k-omura/Quadcopter/README.md

# Quadcopter with PIC18F1230 and ESP8266.
Make a quadcopter from 0.  

PIC18F1230 as the BLDC driver and ESP 8266 as the central control unit.  
Do not use commercially available BLDC ESC.  

----------------------------

# BLDC driver
https://github.com/k-omura/SensorlessBLDC
