k-omura/Quadcopter/cirquit/cirquit.brd

## EAGLE design cirquit/cirquit.brd (2018-01-01)

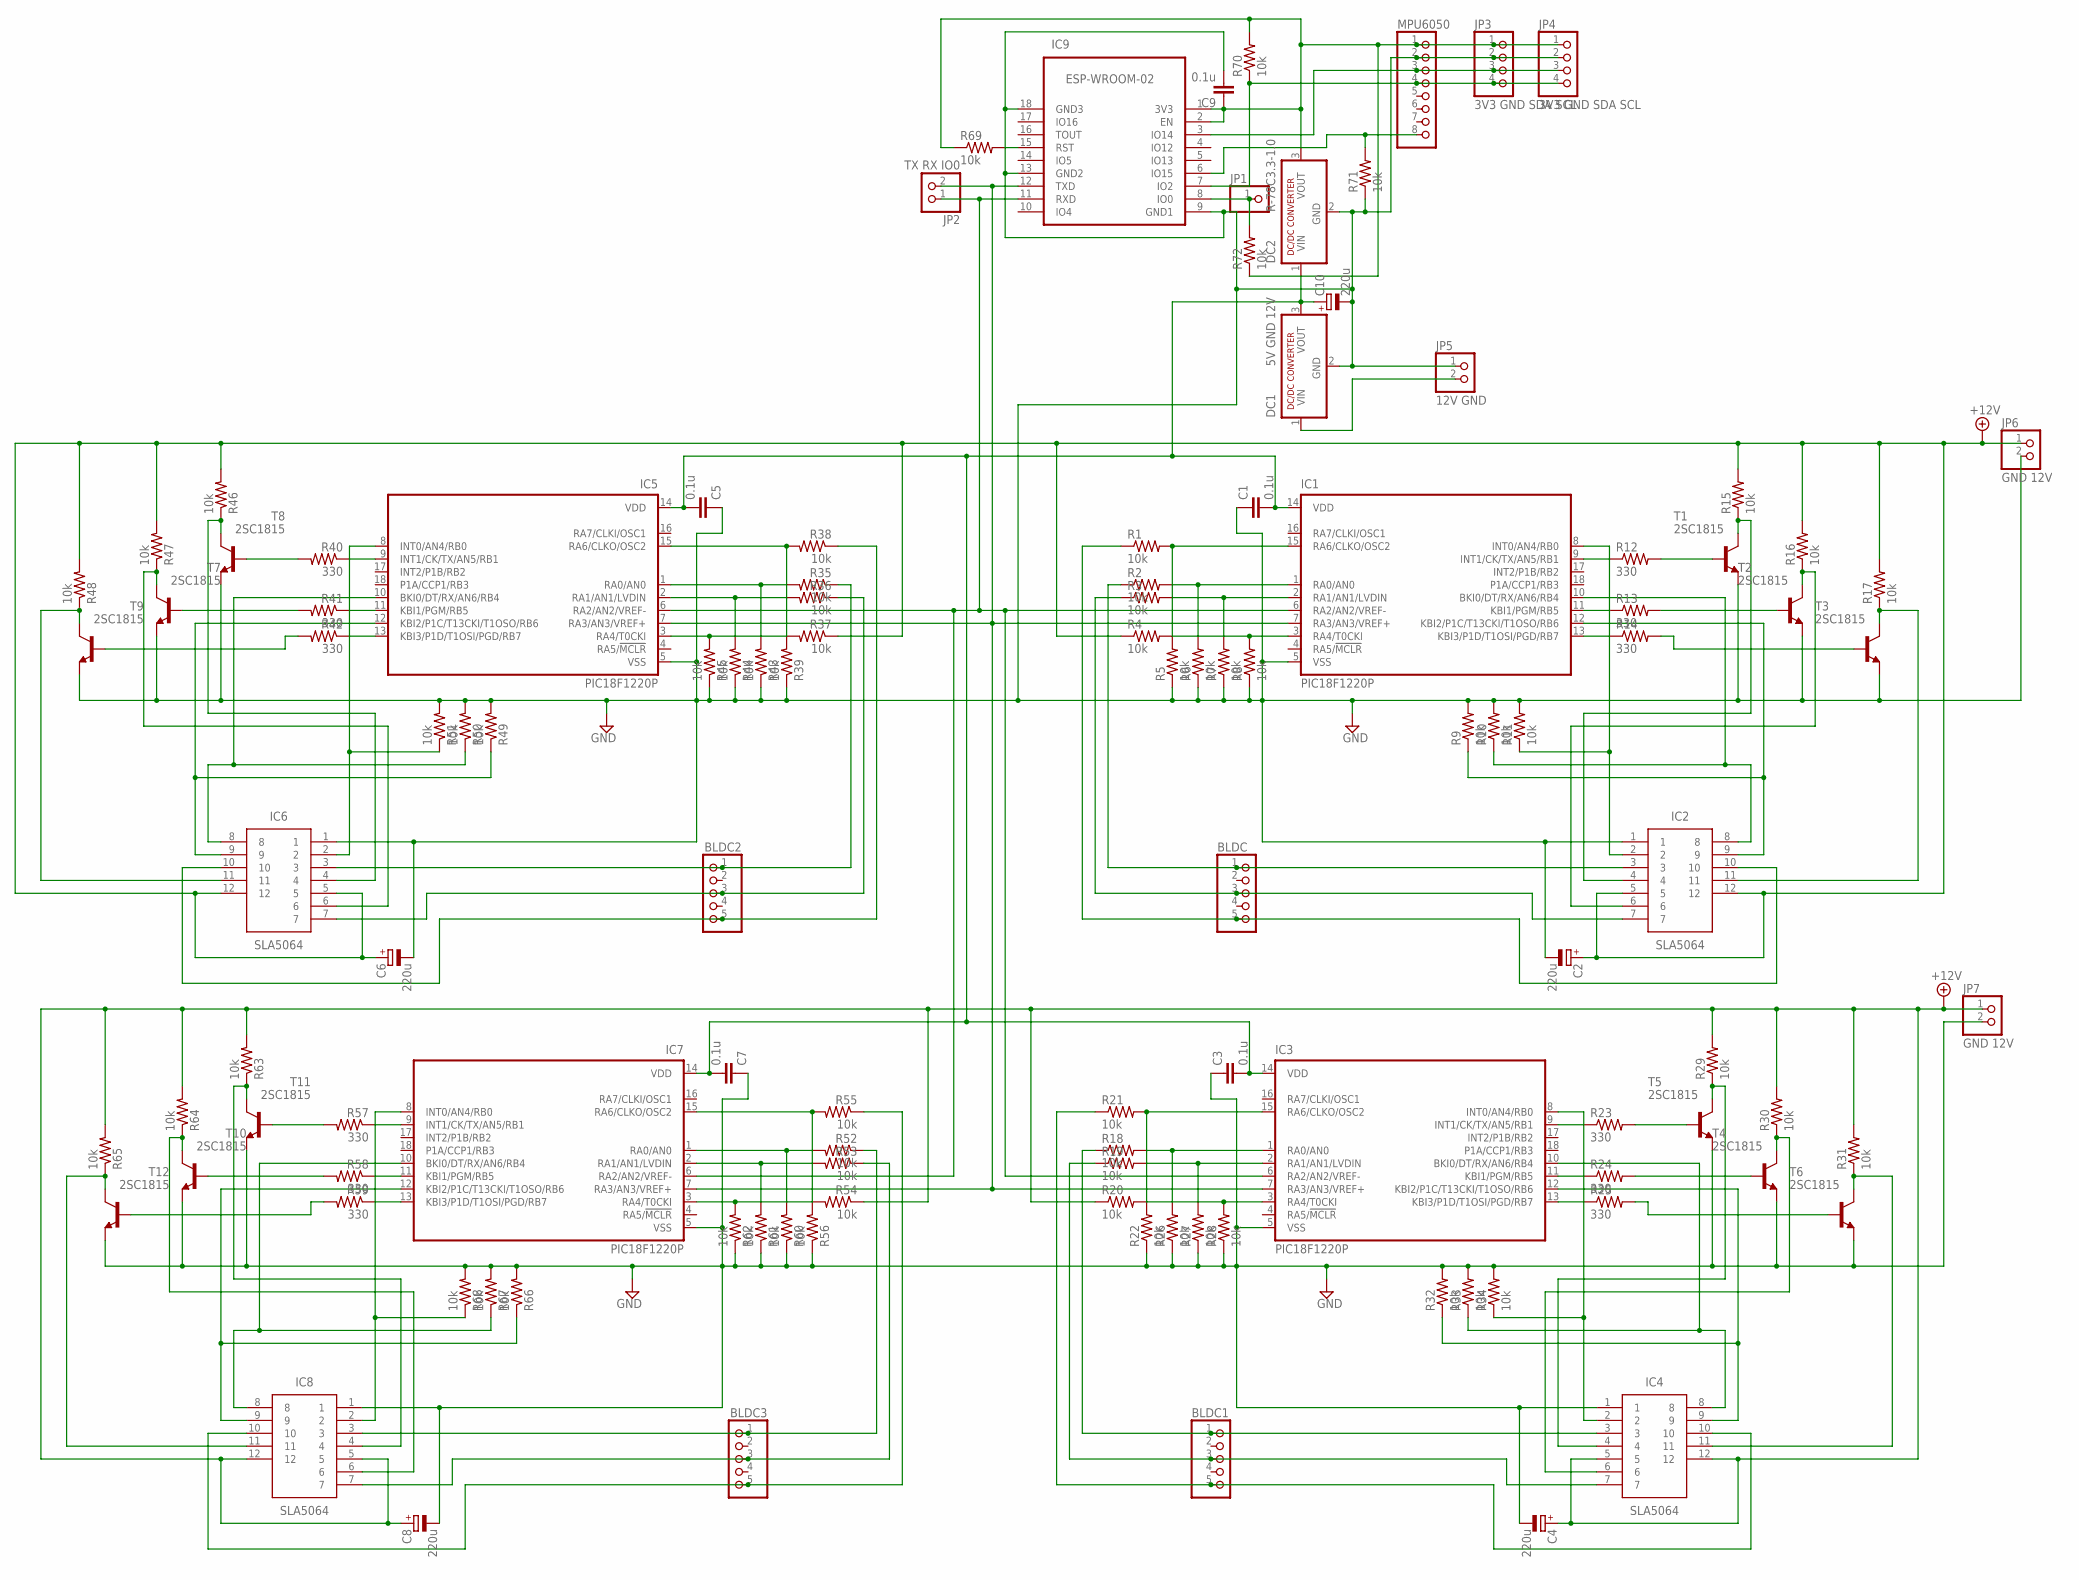
[picture p1: schematic cirquit.sch]

Parts:
BLDC, BLDC1, BLDC2, BLDC3: PINHD-1X5; 1X05
C1, C3, C5, C7, C9: 0.1u; C2.5-2
C2, C4, C6, C8, C10: 220u; E2,5-6E
DC1: 5V GND 12V; SIP3
DC2: R-78C3.3-1.0; SIP3
IC1, IC3, IC5, IC7: PIC18F1220P; DIL18
IC2, IC4, IC6, IC8: SLA5064; TO254P500X3150X1890-12P
IC9: ESP-WROOM-02; FRONT-FACE
JP1: PINHD-1X1; 1X01
JP2: TX RX IO0; 1X02
JP3, JP4: 3V3 GND SDA SCL; 1X04
JP5: 12V GND; 1X02
JP6, JP7: GND 12V; 1X02
MPU6050: PINHD-1X8; 1X08
R1, R2, R3, R4, R5, R6, R7, R8, R9, R10, R11, R15, R16, R17, R18, R19, R20, R21, R22, R26, R27, R28, R29, R30, R31, R32, R33, R34, R35, R36, R37, R38, R39, R43, R44, R45, R46, R47, R48, R49, R50, R51, R52, R53, R54, R55, R56, R60, R61, R62, R63, R64, R65, R66, R67, R68, R69, R70, R71, R72: 10k; 0204/7
R12, R13, R14, R23, R24, R25, R40, R41, R42, R57, R58, R59: 330; 0204/7
T1, T2, T3, T4, T5, T6, T7, T8, T9, T10, T11, T12: 2SC1815; TO92-ECB

Connections:
+12V: C2.+, C4.+, C6.+, C8.+, IC2.5, IC2.12, IC4.5, IC4.12, IC6.5, IC6.12, IC8.5, IC8.12, JP6.1, JP7.1, R4.1, R15.2, R16.2, R17.2, R20.1, R29.2, R30.2, R31.2, R37.1, R46.2, R47.2, R48.2, R54.1, R63.2, R64.2, R65.2
GND: C1.1, C2.-, C3.1, C4.-, C5.1, C6.-, C7.1, C8.-, C9.2, C10.-, DC1.2 (GND), DC2.2 (GND), IC1.5 (VSS), IC2.1, IC3.5 (VSS), IC4.1, IC5.5 (VSS), IC6.1, IC7.5 (VSS), IC8.1, IC9.9 (GND1), IC9.13 (GND2), IC9.18 (GND3), JP3.2, JP4.2, JP5.1, JP6.2, JP7.2, MPU6050.2, R5.1, R6.1, R7.1, R8.1, R9.2, R10.2, R11.2, R22.1, R26.1, R27.1, R28.1, R32.2, R33.2, R34.2, R39.1, R43.1, R44.1, R45.1, R49.2, R50.2, R51.2, R56.1, R60.1, R61.1, R62.1, R66.2, R67.2, R68.2, R71.1, T1.E, T2.E, T3.E, T4.E, T5.E, T6.E, T7.E, T8.E, T9.E, T10.E, T11.E, T12.E
unnamed: IC1.15 (RA6/CLKO/OSC2), R1.2, R5.2
unnamed: IC1.1 (RA0/AN0), R2.2, R6.2
unnamed: IC1.2 (RA1/AN1/LVDIN), R3.2, R7.2
unnamed: IC1.3 (RA4/T0CKI), R4.2, R8.2
unnamed: IC3.15 (RA6/CLKO/OSC2), R21.2, R22.2
unnamed: BLDC.1, IC2.3, R2.1
unnamed: BLDC.3, IC2.7, R3.1
unnamed: IC3.1 (RA0/AN0), R18.2, R26.2
unnamed: IC1.9 (INT1/CK/TX/AN5/RB1), R12.1
unnamed: IC1.11 (KBI1/PGM/RB5), R13.1
unnamed: IC1.13 (KBI3/P1D/T1OSI/PGD/RB7), R14.1
unnamed: R12.2, T1.B
unnamed: R13.2, T2.B
unnamed: R14.2, T3.B
unnamed: IC2.4, R15.1, T1.C
unnamed: IC2.6, R16.1, T2.C
unnamed: IC2.11, R17.1, T3.C
unnamed: IC3.2 (RA1/AN1/LVDIN), R19.2, R27.2
unnamed: IC3.3 (RA4/T0CKI), R20.2, R28.2
unnamed: BLDC1.1, IC4.3, R18.1
unnamed: BLDC1.3, IC4.7, R19.1
unnamed: IC1.8 (INT0/AN4/RB0), IC2.2, R11.1
unnamed: IC1.10 (BKI0/DT/RX/AN6/RB4), IC2.8, R10.1
unnamed: IC1.12 (KBI2/P1C/T13CKI/T1OSO/RB6), IC2.9, R9.1
unnamed: IC1.6 (RA2/AN2/VREF-), IC3.6 (RA2/AN2/VREF-), IC5.6 (RA2/AN2/VREF-), IC7.6 (RA2/AN2/VREF-), IC9.11 (RXD), JP2.1
unnamed: C1.2, C3.2, C5.2, C7.2, C10.+, DC1.3 (VOUT), DC2.1 (VIN), IC1.14 (VDD), IC3.14 (VDD), IC5.14 (VDD), IC7.14 (VDD)
unnamed: IC3.9 (INT1/CK/TX/AN5/RB1), R23.1
unnamed: IC3.11 (KBI1/PGM/RB5), R24.1
unnamed: BLDC.5, IC2.10, R1.1
unnamed: IC3.13 (KBI3/P1D/T1OSI/PGD/RB7), R25.1
unnamed: R23.2, T5.B
unnamed: R24.2, T4.B
unnamed: R25.2, T6.B
unnamed: IC4.4, R29.1, T5.C
unnamed: IC4.6, R30.1, T4.C
unnamed: IC4.11, R31.1, T6.C
unnamed: IC3.8 (INT0/AN4/RB0), IC4.2, R34.1
unnamed: IC3.10 (BKI0/DT/RX/AN6/RB4), IC4.8, R33.1
unnamed: IC3.12 (KBI2/P1C/T13CKI/T1OSO/RB6), IC4.9, R32.1
unnamed: IC5.15 (RA6/CLKO/OSC2), R38.2, R39.2
unnamed: C9.1, DC2.3 (VOUT), IC9.1 (3V3), IC9.2 (EN), JP3.1, JP4.1, MPU6050.1, R69.1, R70.2, R72.1
unnamed: BLDC1.5, IC4.10, R21.1
unnamed: IC5.1 (RA0/AN0), R35.2, R43.2
unnamed: IC5.2 (RA1/AN1/LVDIN), R36.2, R44.2
unnamed: IC5.3 (RA4/T0CKI), R37.2, R45.2
unnamed: BLDC2.1, IC6.3, R35.1
unnamed: BLDC2.3, IC6.7, R36.1
unnamed: IC5.9 (INT1/CK/TX/AN5/RB1), R40.1
unnamed: IC5.11 (KBI1/PGM/RB5), R41.1
unnamed: IC5.13 (KBI3/P1D/T1OSI/PGD/RB7), R42.1
unnamed: R40.2, T8.B
unnamed: R41.2, T7.B
unnamed: R42.2, T9.B
unnamed: IC6.4, R46.1, T8.C
unnamed: IC6.6, R47.1, T7.C
unnamed: IC6.11, R48.1, T9.C
unnamed: IC5.8 (INT0/AN4/RB0), IC6.2, R51.1
unnamed: IC5.10 (BKI0/DT/RX/AN6/RB4), IC6.8, R50.1
unnamed: IC5.12 (KBI2/P1C/T13CKI/T1OSO/RB6), IC6.9, R49.1
unnamed: IC1.7 (RA3/AN3/VREF+), IC3.7 (RA3/AN3/VREF+), IC5.7 (RA3/AN3/VREF+), IC7.7 (RA3/AN3/VREF+), IC9.12 (TXD), JP2.2
unnamed: DC1.1 (VIN), JP5.2
unnamed: BLDC2.5, IC6.10, R38.1
unnamed: IC7.15 (RA6/CLKO/OSC2), R55.2, R56.2
unnamed: IC7.1 (RA0/AN0), R52.2, R60.2
unnamed: IC7.2 (RA1/AN1/LVDIN), R53.2, R61.2
unnamed: IC7.3 (RA4/T0CKI), R54.2, R62.2
unnamed: BLDC3.1, IC8.3, R52.1
unnamed: BLDC3.3, IC8.7, R53.1
unnamed: IC7.9 (INT1/CK/TX/AN5/RB1), R57.1
unnamed: IC7.11 (KBI1/PGM/RB5), R58.1
unnamed: IC7.13 (KBI3/P1D/T1OSI/PGD/RB7), R59.1
unnamed: R57.2, T11.B
unnamed: R58.2, T10.B
unnamed: R59.2, T12.B
unnamed: IC8.4, R63.1, T11.C
unnamed: IC8.6, R64.1, T10.C
unnamed: IC8.11, R65.1, T12.C
unnamed: IC7.8 (INT0/AN4/RB0), IC8.2, R68.1
unnamed: IC7.10 (BKI0/DT/RX/AN6/RB4), IC8.8, R67.1
unnamed: IC7.12 (KBI2/P1C/T13CKI/T1OSO/RB6), IC8.9, R66.1
unnamed: IC9.3 (IO14), JP3.3, JP4.3, MPU6050.3
unnamed: BLDC3.5, IC8.10, R55.1
unnamed: IC9.7 (IO2), JP3.4, JP4.4, MPU6050.4, R70.1
unnamed: IC9.6 (IO15), MPU6050.8, R71.2
unnamed: IC9.15 (RST), R69.2
unnamed: IC9.8 (IO0), JP1.1, R72.2

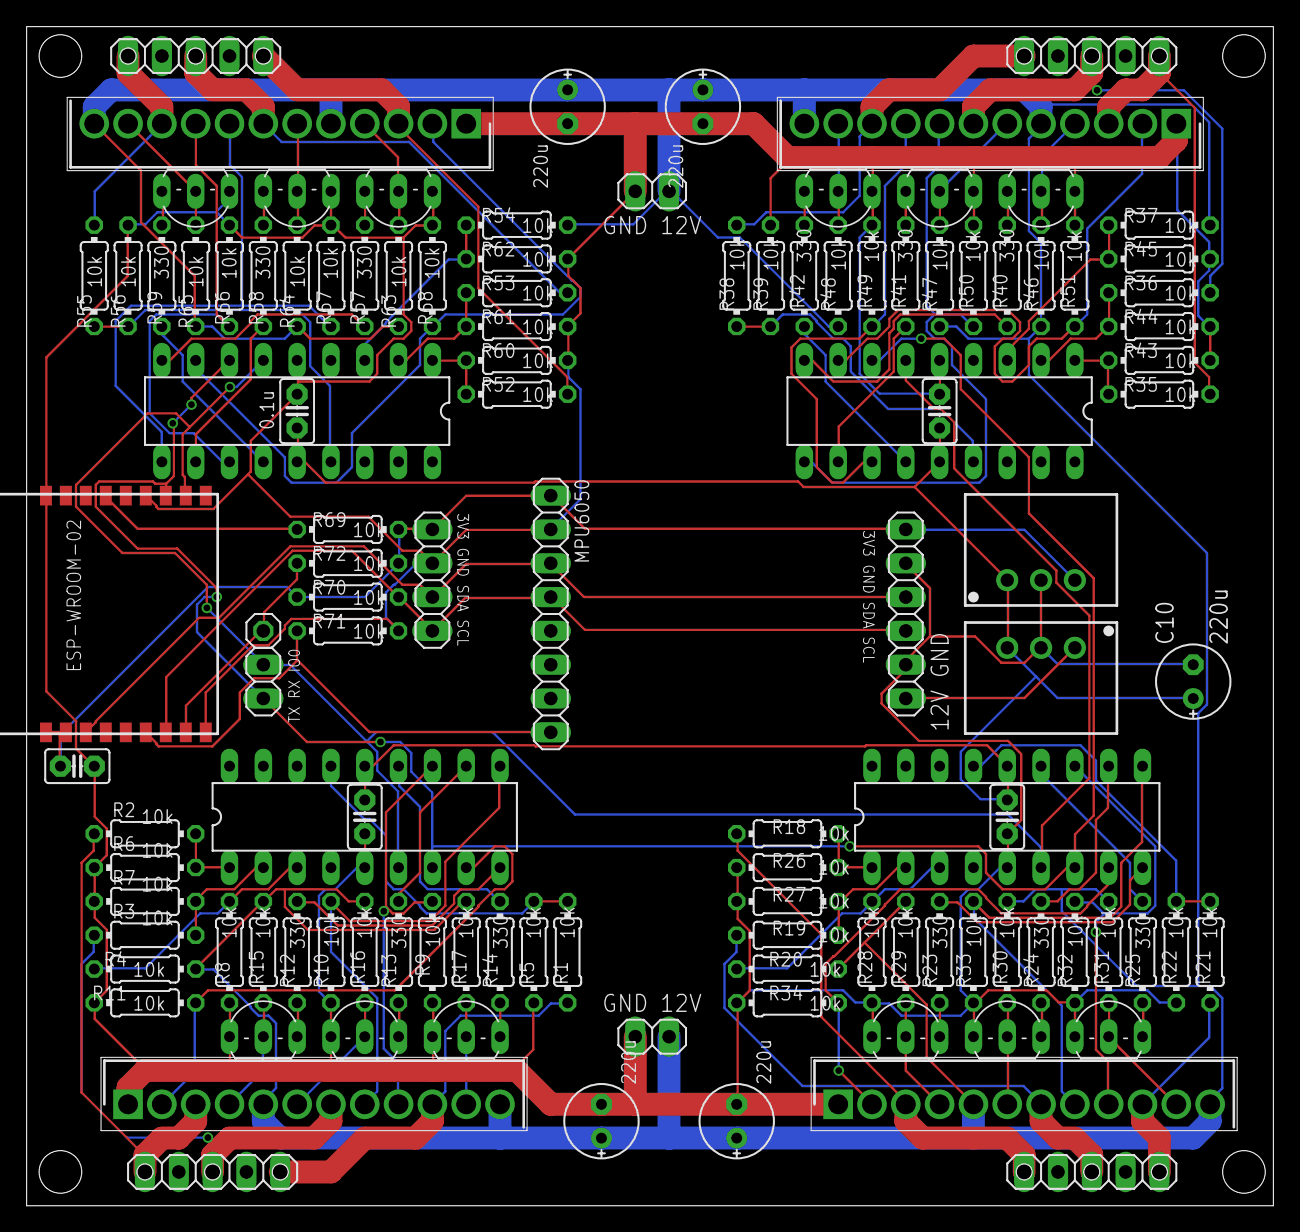
[picture p2: board cirquit.brd from above]

Board: 2 copper layers, 93.7 x 88.6 mm, 117 parts (0 on the bottom side), 88 nets.
