k-omura/Quadcopter/main(BLDC driver).c

/*
 * Created on August 28, 2017
 * August 30, 2017: ADC/PWM test
 * September 10, 2017: Open-loop
 * September 12, 2017: Closed-loop
 * September 13, 2017: Seamless transition Open to Closed, lock detection(CL)
 * January 1, 2018: lock detection(OL)
 * 
 * MPLAB X(XC8)
 * 
 * PWM0: U Nch (Low side)
 * PWM1: U Pch (High side)
 * PWM2: V Nch (Low side)
 * PWM3: V Pch (High side)
 * PWM4: W Nch (Low side)
 * PWM5: W Pch (High side)
 * 
 * ADC0: U
 * ADC1: V
 * ADC2: Supply voltage for motor drive (Vref source -> Vref+ pin)
 * ADC3: W
 * 
 * Speed input EUSART(for quadcopter control)
 * Use RX pin only.
 * Lower 2 bits: address
 * Upper 6 bits: speed data(Absolute)
 */

// PIC18F1230 Configuration Bit Settings

// 'C' source line config statements

// CONFIG1H
#pragma config OSC = INTIO2     // Oscillator (Internal oscillator, port function on RA6 and RA7)
#pragma config FCMEN = OFF      // Fail-Safe Clock Monitor Enable bit (Fail-Safe Clock Monitor disabled)
#pragma config IESO = OFF       // Internal/External Oscillator Switchover bit (Oscillator Switchover mode disabled)

// CONFIG2L
#pragma config PWRT = OFF       // Power-up Timer Enable bit (PWRT disabled)
#pragma config BOR = OFF        // Brown-out Reset Enable bits (Brown-out Reset disabled in hardware and software)
#pragma config BORV = 3         // Brown-out Reset Voltage bits (Minimum setting)

// CONFIG2H
#pragma config WDT = OFF        // Watchdog Timer Enable bit (WDT disabled (control is placed on the SWDTEN bit))
#pragma config WDTPS = 32768    // Watchdog Timer Postscale Select bits (1:32768)

// CONFIG3L
#pragma config PWMPIN = OFF     // PWM Output Pins Reset State Control bit (PWM outputs disabled upon Reset)
#pragma config LPOL = HIGH      // Low-Side Transistors Polarity bit (Even PWM Output Polarity Control bit) (PWM0, PWM2 and PWM4 are active-high (default))
#pragma config HPOL = HIGH      // High Side Transistors Polarity bit (Odd PWM Output Polarity Control bit) (PWM1, PWM3 and PWM5 are active-high (default))

// CONFIG3H
#pragma config FLTAMX = RA5     // FLTA Mux bit (FLTA input is muxed onto RA5)
#pragma config T1OSCMX = LOW    // T1OSO/T1CKI MUX bit (T1OSO/T1CKI pin resides on RB2)
#pragma config MCLRE = OFF      // Master Clear Enable bit (RA5 input pin enabled, MCLR pin disabled)

// CONFIG4L
#pragma config STVREN = OFF     // Stack Overflow/Underflow Reset Enable bit (Reset on stack overflow/underflow disabled)
#pragma config BBSIZ = BB256    // Boot Block Size Select bits (256 Words (512 Bytes) Boot Block size)
#pragma config XINST = OFF      // Extended Instruction Set Enable bit (Instruction set extension and Indexed Addressing mode disabled)

// CONFIG5L
#pragma config CP0 = OFF        // Code Protection bit Block 0 (000400-0007FF) (Block 0 is not code-protected)
#pragma config CP1 = OFF        // Code Protection bit Block 1 (000800-000FFF) (Block 1 is not code-protected)

// CONFIG5H
#pragma config CPB = OFF        // Code Protection bit (Boot Block Memory Area) (Boot Block is not code-protected)
#pragma config CPD = OFF        // Code Protection bit (Data EEPROM) (Data EEPROM is not code-protected)

// CONFIG6L
#pragma config WRT0 = OFF       // Write Protection bit Block 0 (000400-0007FF) (Block 0 is not write-protected)
#pragma config WRT1 = OFF       // Write Protection bit Block 1 (000800-000FFF) (Block 1 is not write-protected)

// CONFIG6H
#pragma config WRTC = OFF       // Write Protection bit (Configuration Registers) (Configuration registers are not write-protected)
#pragma config WRTB = OFF       // Write Protection bit (Boot Block Memory Area) (Boot Block is not write-protected)
#pragma config WRTD = OFF       // Write Protection bit (Data EEPROM) (Data EEPROM is not write-protected)

// CONFIG7L
#pragma config EBTR0 = OFF      // Table Read Protection bit Block 0 (000400-0007FF) (Block 0 is not protected from table reads executed in other blocks)
#pragma config EBTR1 = OFF      // Table Read Protection bit Block 1 (000800-000FFF) (Block 1 is not protected from table reads executed in other blocks)

// CONFIG7H
#pragma config EBTRB = OFF      // Table Read Protection bit (Boot Block Memory Area) (Boot Block is not protected from table reads executed in other blocks)

// #pragma config statements should precede project file includes.
// Use project enums instead of #define for ON and OFF.

#include <xc.h>

#define _XTAL_FREQ 32000000
#define motorADCThreshold 0x80 // (Vmotor / 2) Adjust the value by looking at the oscilloscope, if necessary.
#define CLLockDetectionThreshold 1000
#define OLLockDetectionThreshold 800

//configurations (Set for A2212 13T 1000KV)
#define eusartAddress 0b11 //EUSART Lower 2 bits, use as address.
#define configDirection 0 //rotate direction 0:CW /1:CCW /others:stop
#define configOLDuty 0b00010001 //Open-loop duty
#define configOLInitialSpeed 200 //Open-loop initial speed
#define configOpenToLoopSpeed 50 //Open to close speed (Open-loop max speed)
#define configOLaccelerate 2 //Open-loop "OLInitialSpeed" to "openToLoopSpeed" acceleration
#define configCLaccelerate 30 //Closed-loop acceleration
//configurations end

//functions
int math_abs(int);
void BLDCPosition(int);
void setDuty(unsigned int);
char chageDutySmoothly(unsigned int, unsigned int);
void nextState(unsigned char);

//var
unsigned char motorPosition;
unsigned char direction; //rotation direction. 0, 1, others
unsigned char CLEnable = 0;
unsigned char reachO2CSpeed = 0;
unsigned char LockDetected = 0;

unsigned char eusartReceiveDataGet = 0; //flag read value

typedef union {
    unsigned char raw;

    struct split {
        unsigned int address : 2;
        unsigned int data : 6;
    } split;
} eusartFormat;
eusartFormat eusartReceive;

//const
const unsigned char ADCPortCHS[3] = {0b00, 0b01, 0b11};
const unsigned char feedBackConstant[2][6] = {
    {
        0b00000110,
        0b00000100,
        0b00000101,
        0b00000001,
        0b00000011,
        0b00000010
    },
    {
        0b00000010,
        0b00000110,
        0b00000100,
        0b00000101,
        0b00000001,
        0b00000011
    }
};

void interrupt isr() {
    static unsigned char ADCPortNum = 0; //counter for ADCPortCHS
    static unsigned char ADCValue[3] = {0};
    static unsigned int CLLockDetectionCount = 0, OLLockDetectionCount = 0;
    static int eusartReceiveData = 0, prevEusartReceiveData = 0;

    unsigned char BEMFValue;

    if (PIR1bits.ADIF) {
        ADCValue[ADCPortNum] = ADRESH;

        ADCPortNum = (ADCPortNum >= 2) ? 0 : ADCPortNum + 1;

        if (ADCPortNum == 0) { //AD Convert all of UVW
            //BEMF
            BEMFValue = 0b00000000;
            BEMFValue += (ADCValue[0] > motorADCThreshold) ? 0b00000001 : 0;
            BEMFValue += (ADCValue[1] > motorADCThreshold) ? 0b00000010 : 0;
            BEMFValue += (ADCValue[2] > motorADCThreshold) ? 0b00000100 : 0;

            if ((feedBackConstant[direction][motorPosition] == BEMFValue) && reachO2CSpeed) {
                //change motor position
                nextState(direction);
                CLLockDetectionCount = 0;
                OLLockDetectionCount = 0;
                CLEnable = 1;
            } else if (!CLEnable && reachO2CSpeed && (OLLockDetectionThreshold < OLLockDetectionCount++)) {
                //lock detected(OL)
                reachO2CSpeed = 0;
                BLDCPosition(100);
                setDuty(0x00);
                CLEnable = 0;
                CLLockDetectionCount = 0;
                OLLockDetectionCount = 0;
                LockDetected = 1;
            } else if (CLEnable && (CLLockDetectionThreshold < CLLockDetectionCount++)) {
                //lock detected(CL)
                reachO2CSpeed = 0;
                BLDCPosition(100);
                setDuty(0x00);
                CLEnable = 0;
                CLLockDetectionCount = 0;
                OLLockDetectionCount = 0;
                LockDetected = 1;
            }
        }

        ADCON0bits.CHS = ADCPortCHS[ADCPortNum];
        PIR1bits.ADIF = 0;
    }
    if (PIR1bits.RCIF) {
        if (RCSTAbits.OERR || RCSTAbits.FERR) {//error
            RCSTAbits.CREN = 0;
            eusartReceiveData = RCREG;
            RCSTAbits.CREN = 1;
        } else {
            eusartReceiveData = RCREG;
            //Correspond to irregular input due to noise
            if (eusartReceiveData == prevEusartReceiveData) {
                eusartReceive.raw = eusartReceiveData;
            }
            prevEusartReceiveData = eusartReceiveData;
            eusartReceiveDataGet = 0;
        }
        PIR1bits.RCIF = 0;
    }
    /*
    if (INTCONbits.TMR0IF) {
        INTCONbits.TMR0IF = 0;
    }
     */

    return;
}

void main(void) {
    OSCCON = 0b01110000; //INTOSC 8MHz
    OSCTUNE = 0b01000000; //PLL on

    TRISA = 0b01011011; //AN0-3, RX input
    TRISB = 0b00000000;
    PORTA = 0b00000000;
    PORTB = 0b00000000;

    //interrupt
    INTCON = 0b11000000; //
    INTCON2 = 0b00000000;
    INTCON3 = 0b00000000;

    //configure timer 0
    T0CON = 0b01000000;

    //configure ADC
    ADCON0 = 0b10000000; //Special Event Trigger Enable
    ADCON1 = 0b00010000; //Vref source -> Vref+ pin
    ADCON2 = 0b00001000; //left justified

    //configure PWM
    PTCON0 = 0b00000010; //Postscale 1:1, Fosc/4 Prescale 1:1
    PTCON1 = 0b10000000; //Time base in ON, Time base counts up
    PWMCON0 = 0b01000111; //All PWM I/O pins enabled for PWM output, Independent mode for all pins
    PWMCON1 = 0b00000001; //Postscale 1:1, special event on count downwards, updates from Duty Cycle and Period Buffers enabled
    OVDCOND = 0b00000000;
    OVDCONS = 0b00000000;
    //Period control for all PWM output
    PTPERH = 0x00;
    PTPERL = 0x3f; //8bit PWM
    DTCON = 0b00000110;
    SEVTCMPH = 0;
    SEVTCMPL = 1;
    //FLTCONFIG = 0b00000010;

    PDC0H = 0; //Duty Cycle control for PWM0/1
    PDC0L = 0; //Duty Cycle control for PWM0/1

    PDC1H = 0; //Duty Cycle control for PWM2/3
    PDC1L = 0; //Duty Cycle control for PWM2/3

    PDC2H = 0; //Duty Cycle control for PWM4/5
    PDC2L = 0; //Duty Cycle control for PWM4/5
    chageDutySmoothly(0, 0);

    //configure EUSART receive
    TXSTA = 0b00000100; //BRGH = 1 high speed
    RCSTA = 0b10010000;
    BAUDCON = 0b00001000; //16-bit Baud Rate Generator
    SPBRGH = 0;
    SPBRG = 68; //Baud Rate 9600 (Formula: 9603.842)
    /*
     * SPBRG = 138; //Baud Rate 57600 (Formula: 57553.957)
     * SPBRG = 68; //Baud Rate 115200 (Formula: 115942.029)
     */

    //start timer 0
    T0CONbits.TMR0ON = 0;
    INTCONbits.TMR0IE = 0;

    //start ADC
    ADCON0bits.CHS = ADCPortCHS[0];
    ADCON0bits.ADON = 1;
    __delay_ms(50);
    ADCON0bits.GO_nDONE = 1;
    PIE1bits.ADIE = 1;

    //start EUSART interrupt
    PIE1bits.RCIE = 1;

    //var for open-loop
    unsigned int OLDuty, OLInitialSpeed, openToLoopSpeed, OLaccelerate;
    unsigned int OLSpeedCount, OLAccelerateCount;

    //var for closed-loop
    unsigned int CLDuty, CLaccelerate, CLInitialSpeedReached;

    //var others
    int duty;
    unsigned char reachTargetSpeed = 1; //flag 

    //Initial configuration
    direction = configDirection; //rotate direction 0:CW /1:CCW /others:stop
    OLDuty = configOLDuty; //Open-loop duty
    OLInitialSpeed = configOLInitialSpeed; //Open-loop initial speed
    openToLoopSpeed = configOpenToLoopSpeed; //Open to close speed (Open-loop max speed)
    OLaccelerate = configOLaccelerate; //Open-loop "OLInitialSpeed" to "openToLoopSpeed" acceleration
    CLaccelerate = configCLaccelerate; //Closed-loop acceleration
    //Initial configuration end

    //initialize
    LockDetected = 1; //motor is stopped in the initial state.
    CLDuty = 0;
    CLInitialSpeedReached = 0;
    //initialize end

    __delay_ms(1000);

    //main motor control part
    while (1) {
        if (LockDetected) {
            //initialize. first start or lock detected(CL)
            duty = 0x00;
            motorPosition = 0; //Motor initial position
            CLEnable = 0; //Closed-loop enable flag
            OLAccelerateCount = OLInitialSpeed;
            chageDutySmoothly(OLDuty, 0); //initialize static var in function "prevDuty".
            LockDetected = 0;
            CLInitialSpeedReached = 0;
            reachO2CSpeed = 0;
            reachTargetSpeed = 1;
            //initialize end
        }

        if (!CLEnable && CLDuty) { //start motor with open-loop
            setDuty(duty);

            duty = (duty < OLDuty) ? duty + 1 : OLDuty;
            OLAccelerateCount = ((OLAccelerateCount - OLaccelerate) > openToLoopSpeed) ? (OLAccelerateCount - OLaccelerate) : openToLoopSpeed;

            //change motor position
            nextState(direction);

            //transition to closed-loop
            if (OLAccelerateCount == openToLoopSpeed) {
                reachO2CSpeed = 1;
            }

            for (OLSpeedCount = 0; OLSpeedCount < OLAccelerateCount; OLSpeedCount++) {
                __delay_us(10);
            }
        } else { //Closed-loop
            reachTargetSpeed = chageDutySmoothly(duty, CLaccelerate);
            if (reachTargetSpeed) {
                duty = CLDuty;
            }
        }

        //Processing EUSART speed input 
        if ((eusartReceive.split.address == eusartAddress) && !eusartReceiveDataGet) {
            eusartReceiveDataGet = 1;
            if (eusartReceive.split.data) {
                CLDuty = (eusartReceive.split.data << 1) + 0b10000001;
            } else {
                //EUSART input 0
                reachO2CSpeed = 0;
                BLDCPosition(100);
                setDuty(0x00);
                CLEnable = 0;
                CLDuty = 0;
                CLInitialSpeedReached = 0;
                LockDetected = 1;
                reachTargetSpeed = 0;
            }
        }
    }

    return;
}

//math abs

int math_abs(int value) {
    return (value >= 0) ? value : -value;
}

//PWM on/off setting

void BLDCPosition(const int state) {
    switch (state) {
        case 0:
            OVDCOND = 0b00001001;
            break;
        case 1:
            OVDCOND = 0b00100001;
            break;
        case 2:
            OVDCOND = 0b00100100;
            break;
        case 3:
            OVDCOND = 0b00000110;
            break;
        case 4:
            OVDCOND = 0b00010010;
            break;
        case 5:
            OVDCOND = 0b00011000;
            break;
        default:
            OVDCOND = 0b00000000;
            break;
    }

    return;
}

//PWM duty ratio = Current supply to motor = speed of motor(closed-loop))

void setDuty(unsigned int setDuty) {
    if (setDuty > 0xff) {
        setDuty = 0xff;
    }
    PDC0L = setDuty;
    PDC1L = setDuty;
    PDC2L = setDuty;

    return;
}

//change PWM duty ratio smoothly. Output 1 when the target speed is reached.

char chageDutySmoothly(unsigned int targetDuty, unsigned int acceleration) {
    static unsigned int prevDuty = 0;
    int accelerateCount;

    if (targetDuty > 0xff) {
        targetDuty = 0xff;
    }

    if (targetDuty == prevDuty) {
        return 1;
    }

    if (acceleration == 0) {
        prevDuty = targetDuty;
        return 1;
    }

    //Preventing step-out by rapid acceleration.
    /*
    if (math_abs(targetDuty - prevDuty) > 128) {
        acceleration = 100;
    }
     */

    prevDuty = (targetDuty > prevDuty) ? (prevDuty + 1) : (prevDuty - 1);
    setDuty(prevDuty);

    if (targetDuty == prevDuty) {
        return 1;
    }

    for (accelerateCount = 0; accelerateCount < acceleration; accelerateCount++) {
        __delay_us(1);
    }

    return 0;
}

//rotate

void nextState(const unsigned char directionSet) {
    if (directionSet == 0) {
        motorPosition = (motorPosition == 5) ? 0 : motorPosition + 1;
    } else if (directionSet == 1) {
        motorPosition = (motorPosition == 0) ? 5 : motorPosition - 1;
    } else {
        //stop
        reachO2CSpeed = 0;
        BLDCPosition(100);
        setDuty(0x00);
        CLEnable = 0;
        LockDetected = 1;
    }
    BLDCPosition(motorPosition);

    return;
}
