k-omura/Quadcopter/(commit log)

2017-11-26 Main Arduino file
    For testing circuits around the motor
2017-12-16 BLDC driver for PIC18F1230
    Same as Sensorless BLDC project. However, the position to insert 6 bits for motor speed control was changed.
2017-12-19 Update main(BLDC driver).c
